Kingofstrix/random-positioning-machine/docs/README.md

# docs

Shared documentation for all teams.

| File | Content |
|---|---|
| `PLAN.md` | Plan for the firmware and the MuJoCo simulation: hardware facts, architecture, tests, milestones |
| `interfaces.md` | Pins, units, coordinate frames and the serial protocol shared between teams |
