Kingofstrix/random-positioning-machine/rpm_printables/04_spur_gear_large_outer.stl

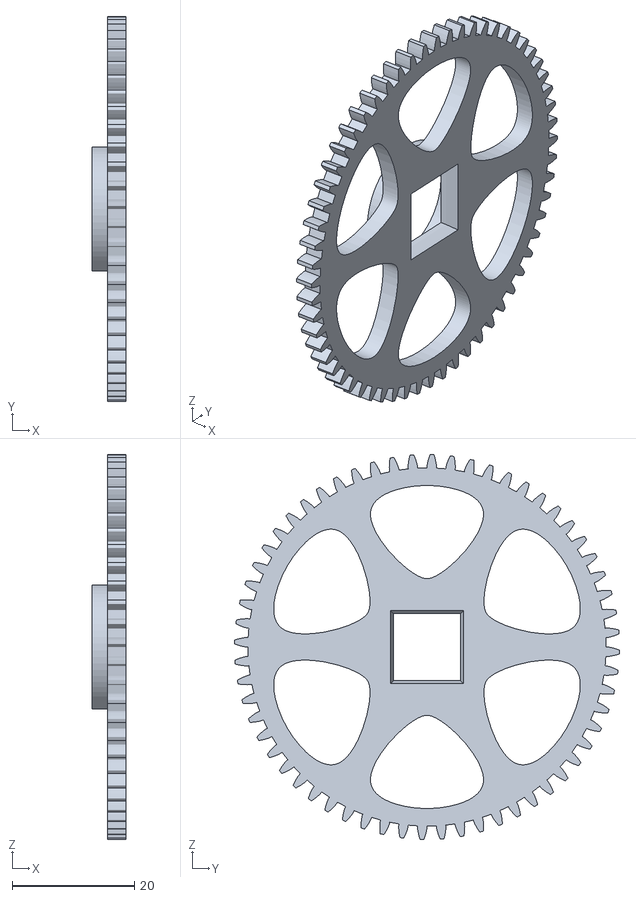
[picture p1: CAD file, 2026-11-07]
rpm_printables/04_spur_gear_large_outer.stl
5.50 x 63.0 x 63.0
