Kingofstrix/random-positioning-machine/rpm_printables/optional_stand/Stand.stl

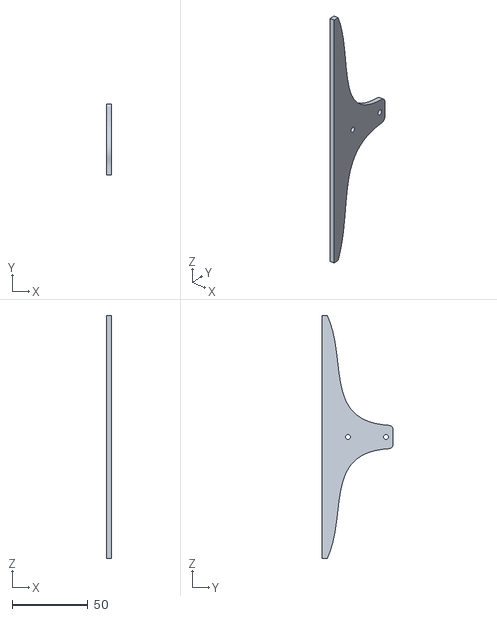
[picture p2: CAD file, 2026-11-07]
rpm_printables/optional_stand/Stand.stl
3.00 x 47.0 x 160.0
