Kingofstrix/random-positioning-machine/rpm_printables/05_spur_gear_large_inner.stl

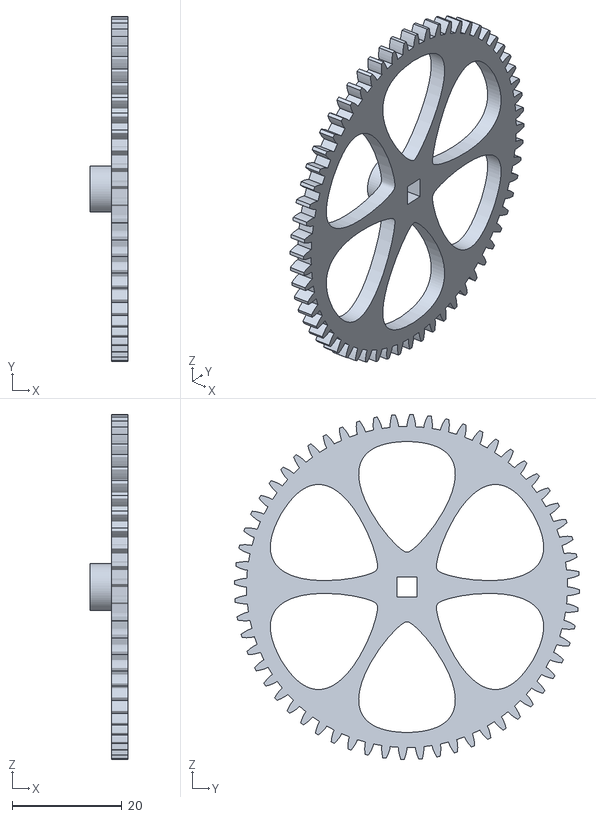
[picture p3: CAD file, 2026-11-07]
rpm_printables/05_spur_gear_large_inner.stl
7.00 x 63.0 x 63.0
