Kingofstrix/random-positioning-machine/rpm_printables/06_spur_gear_small.stl

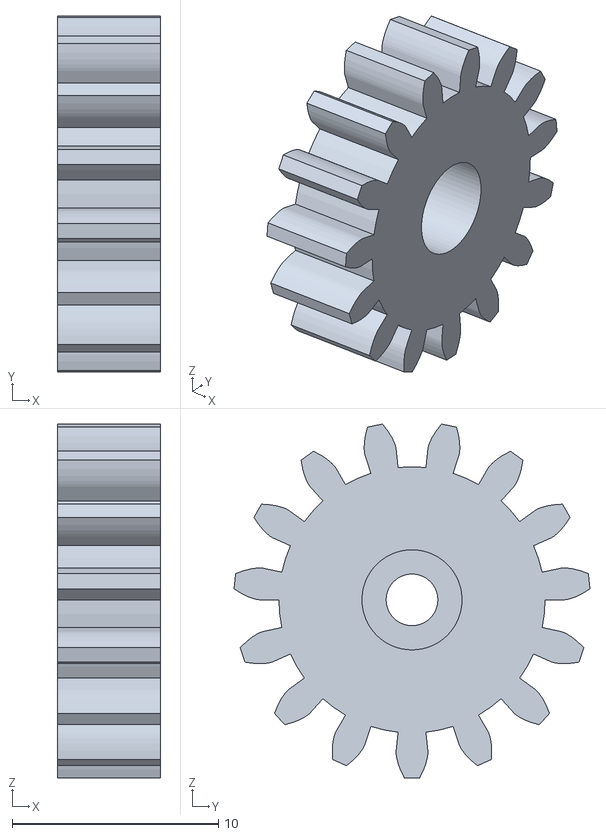
[picture p4: CAD file, 2026-11-07]
rpm_printables/06_spur_gear_small.stl
5.00 x 17.2 x 17.1
