Kingofstrix/random-positioning-machine/rpm_printables/07_end_cap.stl

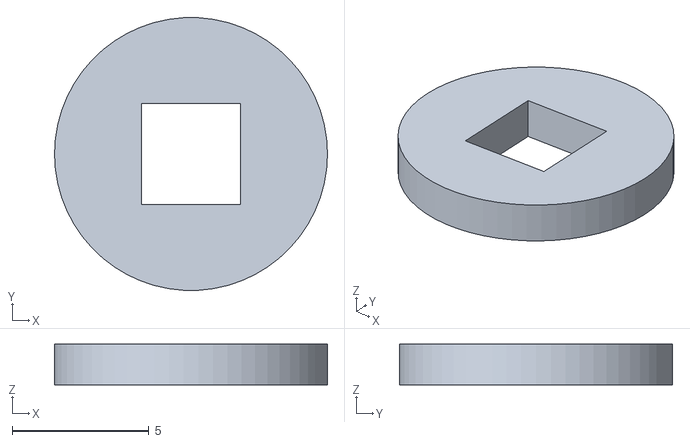
[picture p5: CAD file, 2026-11-07]
rpm_printables/07_end_cap.stl
10.0 x 9.99 x 1.50
