Kingofstrix/random-positioning-machine/rpm_printables/01_outer_frame.stl

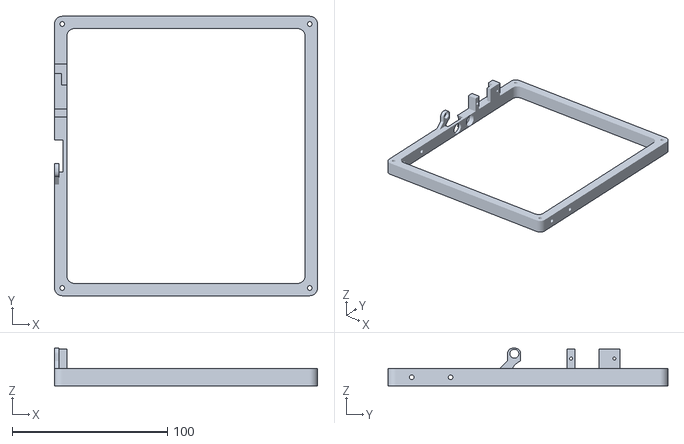
[picture p6: CAD file, 2026-11-07]
rpm_printables/01_outer_frame.stl
169.2 x 179.9 x 24.2
