Kingofstrix/random-positioning-machine/rpm_printables/03_experiment_platform.stl

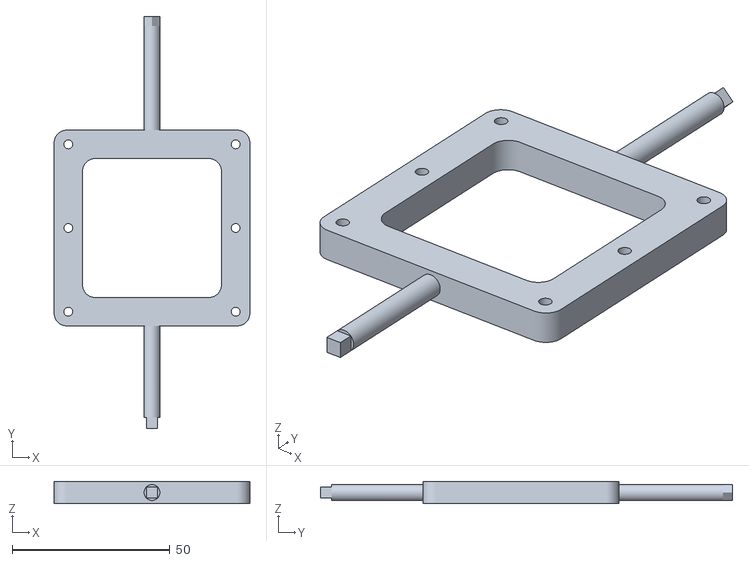
[picture p7: CAD file, 2026-11-07]
rpm_printables/03_experiment_platform.stl
62.0 x 130.5 x 7.00
