Kingofstrix/random-positioning-machine/rpm_printables/02_inner_frame.stl

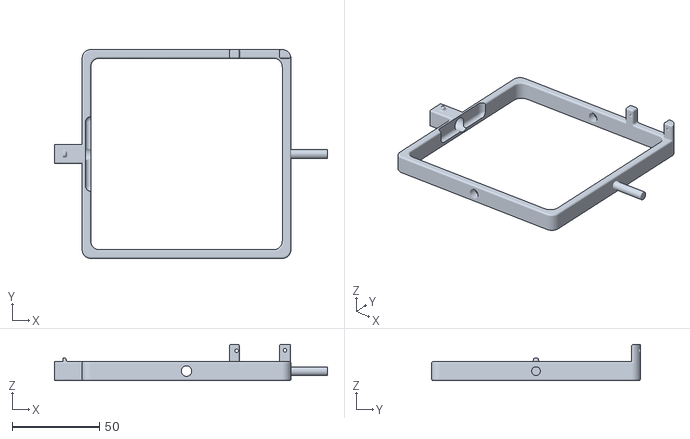
[picture p8: CAD file, 2026-11-07]
rpm_printables/02_inner_frame.stl
156.9 x 120.0 x 20.9
