Kingofstrix/random-positioning-machine/rpm_printables/README.txt

Random Positioning Machine, print set

Design: Core Electronics and Unconvengineering
https://github.com/CoreElectronics/CE-Random-Positioning-Machine
Licence: CC BY-NC-SA 4.0
https://creativecommons.org/licenses/by-nc-sa/4.0/

Changed from the original by Mark Schutera, DHBW Ravensburg:
  01_outer_frame.stl          four corner holes added, 3.0 mm, otherwise unchanged
  03_experiment_platform.stl  collar replaced by an open frame with six M2.5 nut
                              seats, shaft ends unchanged
All other parts are unchanged, their files only renamed.

Print
  01_outer_frame.stl            1x
  02_inner_frame.stl            1x
  03_experiment_platform.stl    1x
  04_spur_gear_large_outer.stl  1x
  05_spur_gear_large_inner.stl  1x
  06_spur_gear_small.stl        2x, one per servo
  07_end_cap.stl                1x
  optional_stand/Stand.stl      2x, only if the machine should stand on its own

Buy
  2 servos, 1 slip ring, 4 servo screws, a Raspberry Pi Pico, a breadboard,
  jumper wires, cable ties, and 4 M3x6 bolts for the stands

Build
  Assembly Instructions - Random Positioning Machine.pdf is the original guide.
  Its control code is in the repository linked above.
