Kingofstrix/random-positioning-machine/testing/results/README.md

# testing/results/

One Markdown report per test run, written by `../run_tests.py`.
File name: `<YYYY-MM-DD_HHMM>_<topic|all>.md`. Reports are committed via PR and never edited afterwards.
