Kingofstrix/random-positioning-machine/testing/gravity-estimate/vectors.csv

scenario | t_s | gres | cov
still | 0 | 1.000 | 0.000
still | 10 | 1.000 | 0.005
still | 20 | 1.000 | 0.005
still | 30 | 1.000 | 0.005
still | 40 | 1.000 | 0.005
still | 50 | 1.000 | 0.005
still | 60 | 1.000 | 0.005
inner_only | 0 | 1.000 | 0.000
inner_only | 10 | 1.000 | 0.005
inner_only | 20 | 1.000 | 0.005
inner_only | 30 | 1.000 | 0.005
inner_only | 40 | 1.000 | 0.005
inner_only | 50 | 1.000 | 0.005
inner_only | 60 | 1.000 | 0.005
clino3d | 0 | 1.000 | 0.000
clino3d | 10 | 0.514 | 0.130
clino3d | 20 | 0.267 | 0.240
clino3d | 30 | 0.029 | 0.340
clino3d | 40 | 0.119 | 0.445
clino3d | 50 | 0.110 | 0.540
clino3d | 60 | 0.029 | 0.620
clino3d | 70 | 0.062 | 0.695
clino3d | 80 | 0.070 | 0.750
clino3d | 90 | 0.028 | 0.805
clino3d | 100 | 0.038 | 0.840
clino3d | 110 | 0.050 | 0.870
clino3d | 120 | 0.028 | 0.910
clino3d | 130 | 0.026 | 0.935
clino3d | 140 | 0.039 | 0.950
clino3d | 150 | 0.027 | 0.965
clino3d | 160 | 0.017 | 0.980
clino3d | 170 | 0.031 | 0.990
clino3d | 180 | 0.026 | 0.995
clino3d | 190 | 0.012 | 0.995
clino3d | 200 | 0.025 | 1.000
clino3d | 210 | 0.025 | 1.000
clino3d | 220 | 0.009 | 1.000
clino3d | 230 | 0.020 | 1.000
clino3d | 240 | 0.023 | 1.000
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
