Kingofstrix/random-positioning-machine/(commit log)

2026-11-07 chore: add printable parts, contributing guide and PR template
    [01_outer_frame.stl, 02_inner_frame.stl, 03_experiment_platform.stl, 04_spur_gear_large_outer.stl, 05_spur_gear_large_inner.stl, 06_spur_gear_small.stl, 07_end_cap.stl, Stand.stl]
2026-11-07 docs: correct MuJoCo wheel note in plan
2026-11-07 chore(sim): add simulation project scaffold (M0)
    Package layout under simulation/ with rpmcore mapped from firmware/,
    editable install via pyproject (mujoco pinned <4, 4.0.0 is sdist only),
    slow marker, and a scaffold test that guards imports and the STL path
    into rpm_printables/.
2026-11-07 feat(sim): add xorshift32 PRNG to rpmcore
    Same sequence on the Pico and in CPython; random() uses the top 24 bits so
    it is exact in float32 and never returns 1.0. Seed-1 values are pinned for
    the Pico selftest, Marsaglia's reference values anchor the algorithm.
2026-11-07 feat(sim): add CONFIG and per-direction servo calibration map
    ServoMap converts frame deg/s to pulse us via piecewise-linear tables per
    direction. Rounds to the nearest us, but any non-zero speed gets at least
    one us past its own deadband edge; beyond the table it holds saturation,
    then clamps to [min_us, max_us]. NaN calibration points are rejected.
2026-11-07 docs: align servo_map rounding and hold-time notes with implementation
2026-11-07 feat(test): add interactive test runner with per-topic steps
    Python CLI (testing/run_tests.py) with --topic hardware|software|test,
    manual pass/fail/skip steps from YAML, coloured terminal summary and
    one Markdown report per run in testing/results/.
    [hardware.yaml]
2026-11-07 fix(test): shorten time-based test steps
    Continuous run 10 min -> 3 min with the sample mounted, 1 h endurance
    run merged into it, random-motion check 2 min -> 30 s.
2026-11-07 fix(test): align test steps with current simulation and interfaces
    Software steps now use the MicroPython/MuJoCo setup, pytest suite and
    documented commands instead of a C++ build. Steps for unmerged
    milestones are marked 'Skip until M<n>'. Hardware wiring and power steps
    follow docs/interfaces.md (servos powered via VBUS). System steps add
    pin check, neutral check and stop/estop via serial commands.
    [hardware.yaml]
2026-11-07 docs: update README to MicroPython/MuJoCo stack and current status
    Replaces the outdated C++/Arduino stack, fixes the axis description
    (outer frame is fixed), lists the existing folders, adds milestone
    status, getting-started commands and the VBUS power note.
2026-11-07 feat(interface): give every run an ID and use it as default sample name
2026-11-07 feat(test): add gravity estimate spec, reference and test vectors for the Nano
    [vectors.csv]
2026-11-07 feat(interface): add laptop launcher that bridges the Arduino serial port to the page
2026-11-07 feat(interface): launcher --forward copies serial traffic to sim.hil
    Replaces the page-side forwarding of the earlier version of this PR,
    since #30 moved the serial port from the page into the launcher. With
    --forward the launcher sends every line both ways as JSON lines over
    local TCP (127.0.0.1:8766) to python -m sim.hil, keeps the Nano's boot
    output for it instead of discarding it, and never blocks the serial
    loop. Telemetry lines of the Nano's test build never reach the page.
    [launcher.py]
